NaruephonBoonmak/delta-uwb-presentation/assets/bom_r19/output/Poster_BOM_R19/transparent/04_BELT_MODULES_DETAIL_transparent.png

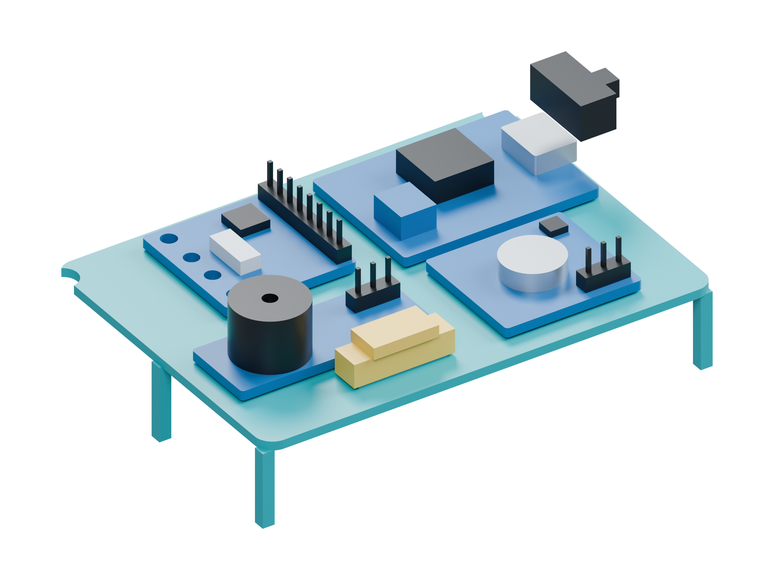
assets/bom_r19/output/Poster_BOM_R19/transparent/04_BELT_MODULES_DETAIL_transparent.png
