NaruephonBoonmak/delta-uwb-presentation/assets/cover/delta-agv-integrated-tag-cover.png

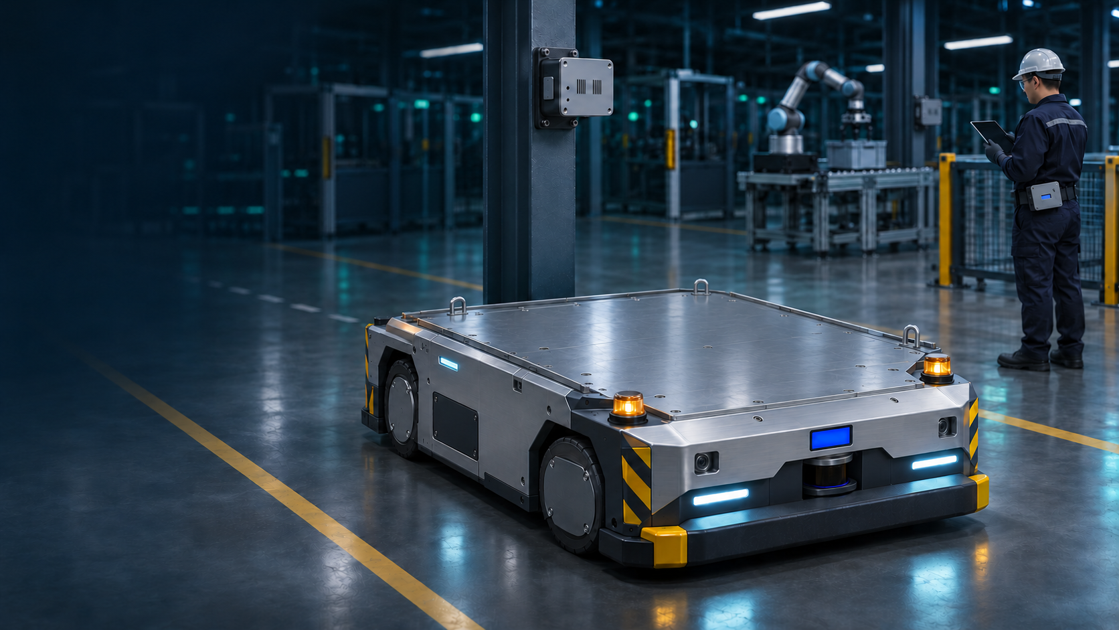
assets/cover/delta-agv-integrated-tag-cover.png
