NaruephonBoonmak/delta-uwb-presentation/assets/cover/delta-dark-factory-cover.png

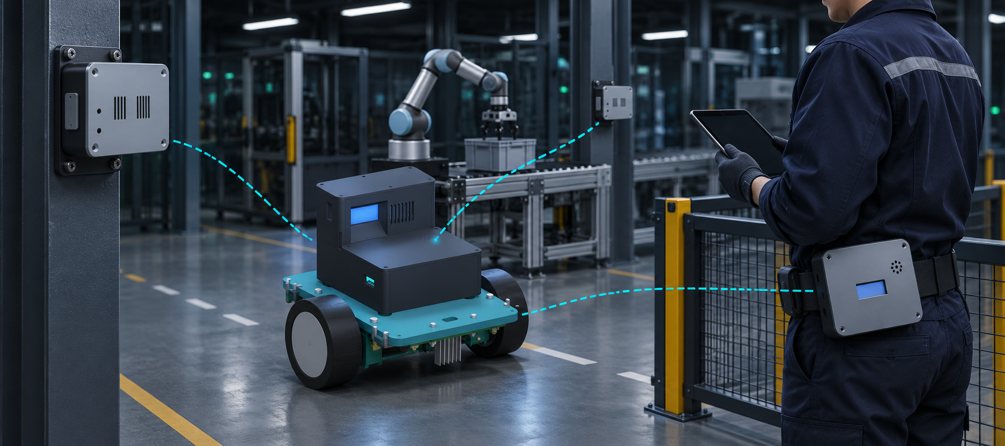
assets/cover/delta-dark-factory-cover.png
