NaruephonBoonmak/delta-uwb-presentation/assets/cover/delta-industrial-agv-cover.png

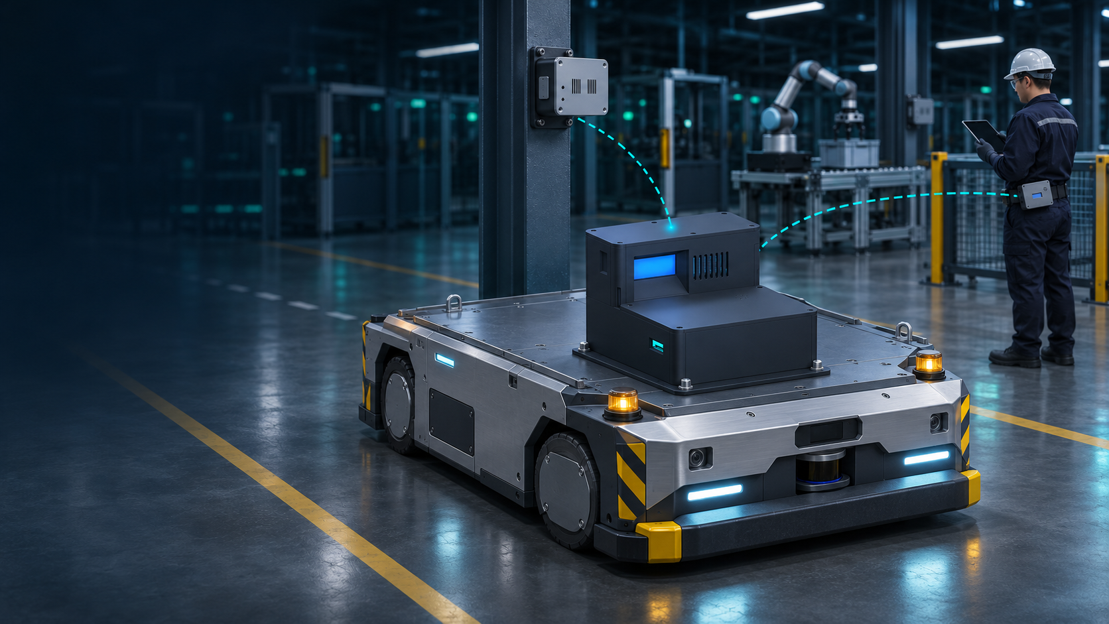
assets/cover/delta-industrial-agv-cover.png
