NaruephonBoonmak/delta-uwb-presentation/assets/cover/dtia-kmitl.webp

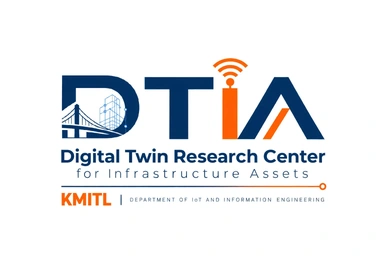
assets/cover/dtia-kmitl.webp
