NaruephonBoonmak/delta-uwb-presentation/assets/cover/kmitl-emblem.png

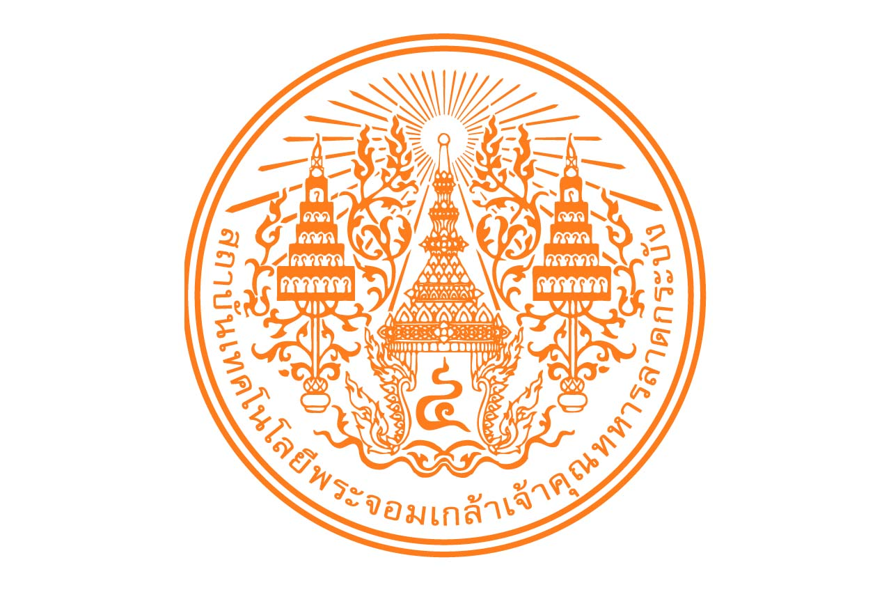
assets/cover/kmitl-emblem.png
