NaruephonBoonmak/delta-uwb-presentation/assets/cover/mecheci404-wordmark.png

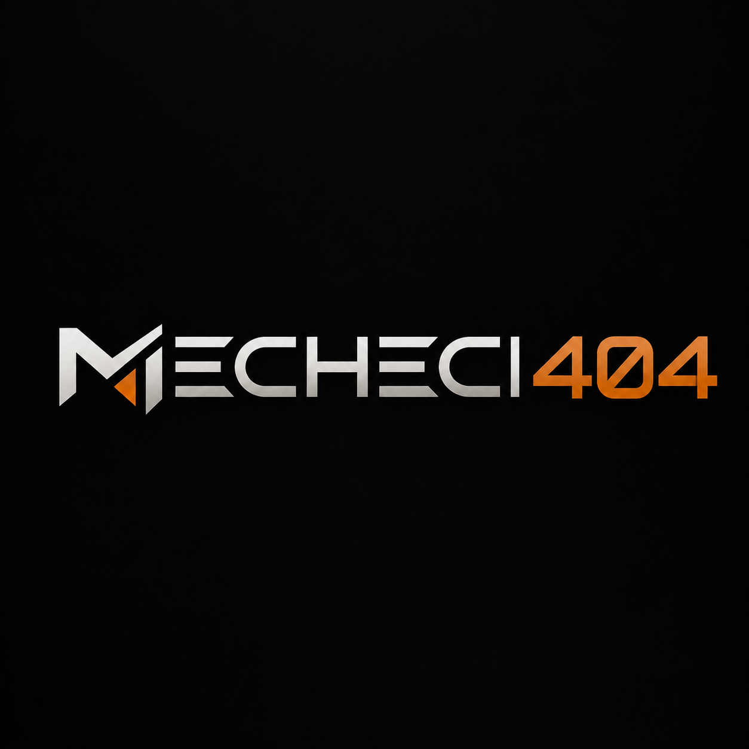
assets/cover/mecheci404-wordmark.png
