NaruephonBoonmak/delta-uwb-presentation/assets/package/04_Conveyor_450mm/Images/Conveyor_450_Rails_Aligned.png

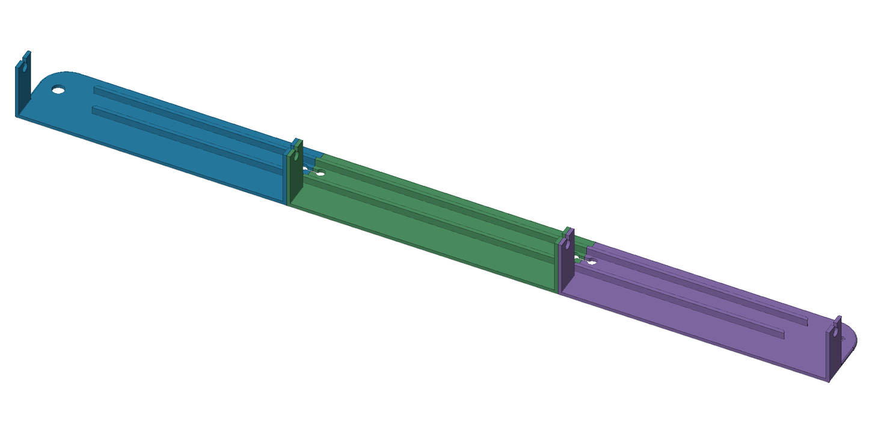
assets/package/04_Conveyor_450mm/Images/Conveyor_450_Rails_Aligned.png
