NaruephonBoonmak/delta-uwb-presentation/assets/package/04_Conveyor_450mm/Images/Conveyor_Source_CAD.png

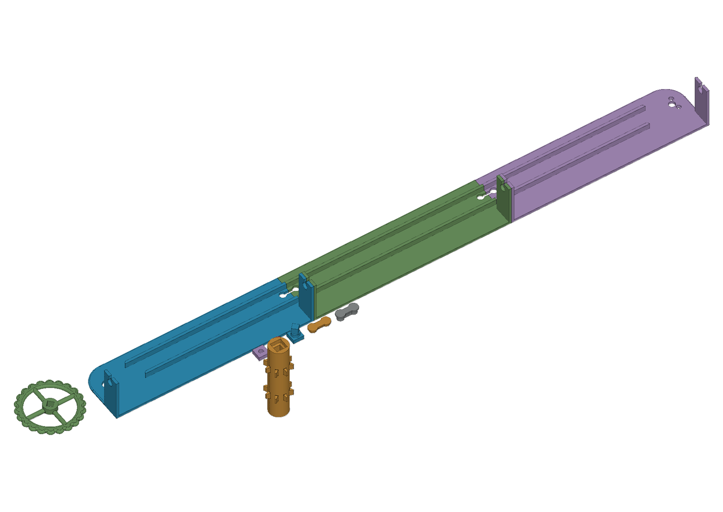
assets/package/04_Conveyor_450mm/Images/Conveyor_Source_CAD.png
