NaruephonBoonmak/delta-uwb-presentation/assets/package/04_Conveyor_450mm/Images/KW11_Bolted_Mount_Preview.png

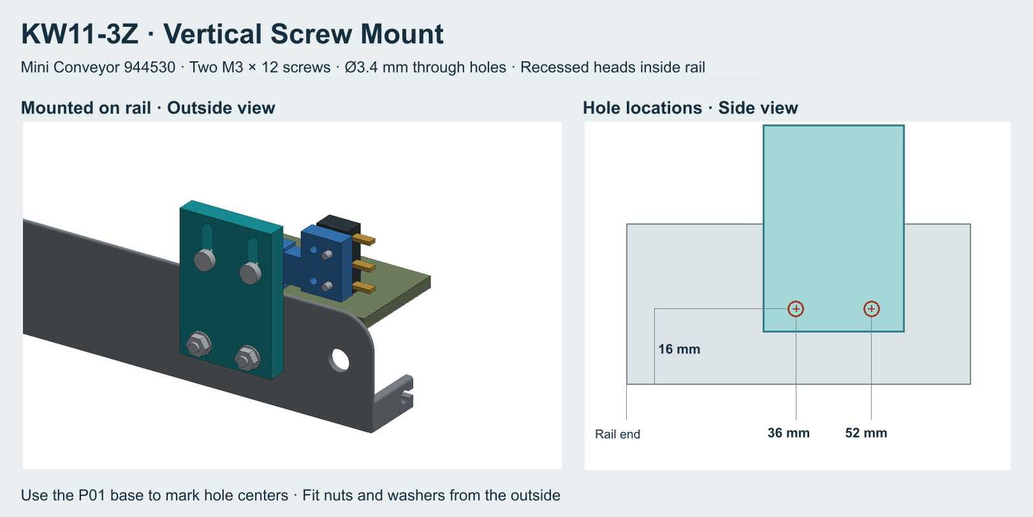
assets/package/04_Conveyor_450mm/Images/KW11_Bolted_Mount_Preview.png
