NaruephonBoonmak/delta-uwb-presentation/assets/package/05_AGV_Display_Stand_S01/Images/AGV_On_Stand_Baseline.png

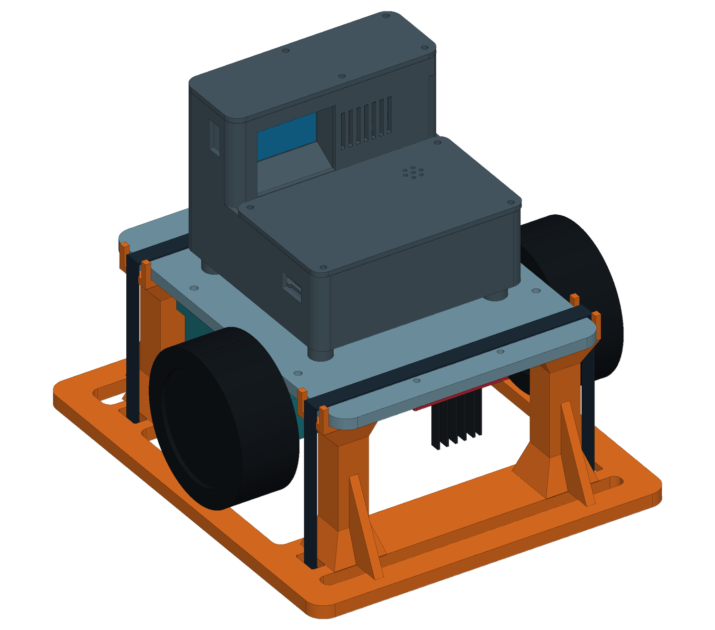
assets/package/05_AGV_Display_Stand_S01/Images/AGV_On_Stand_Baseline.png
