NaruephonBoonmak/delta-uwb-presentation/assets/package/05_AGV_Display_Stand_S01/Images/AGV_R20_Dual_TT_On_S01.png

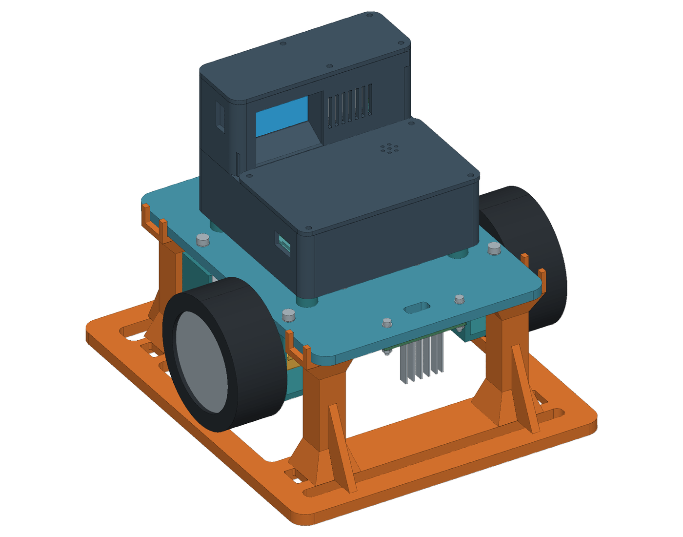
assets/package/05_AGV_Display_Stand_S01/Images/AGV_R20_Dual_TT_On_S01.png
