NaruephonBoonmak/delta-uwb-presentation/assets/package/05_AGV_Display_Stand_S01/Images/Stand_Clearance_Baseline.png

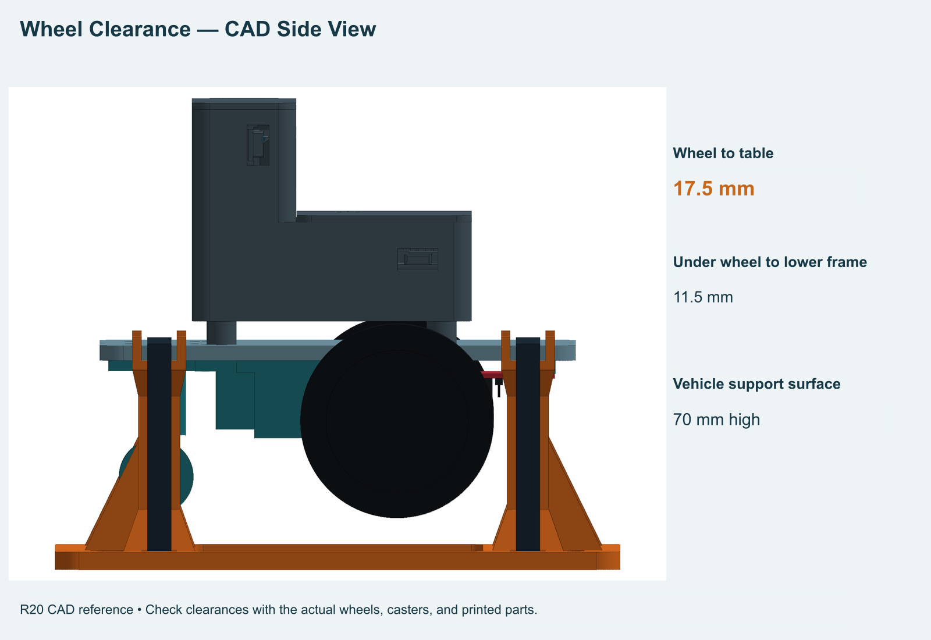
assets/package/05_AGV_Display_Stand_S01/Images/Stand_Clearance_Baseline.png
