NaruephonBoonmak/delta-uwb-presentation/assets/package/05_AGV_Display_Stand_S01/Images/Stand_Only.png

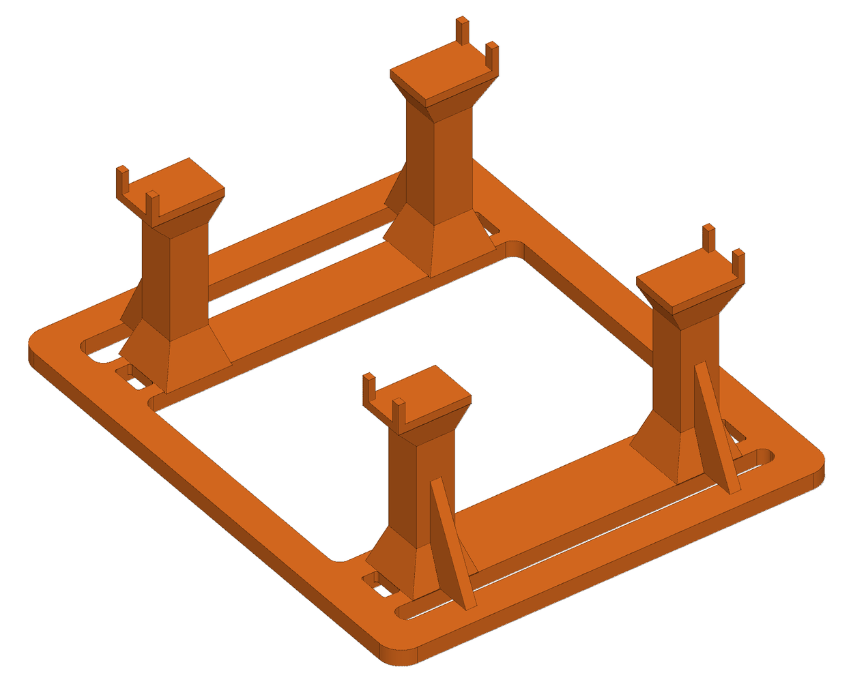
assets/package/05_AGV_Display_Stand_S01/Images/Stand_Only.png
