NaruephonBoonmak/delta-uwb-presentation/assets/package/08_Booth_Layout/Images/Booth_1800x600_Conveyor_450mm.png

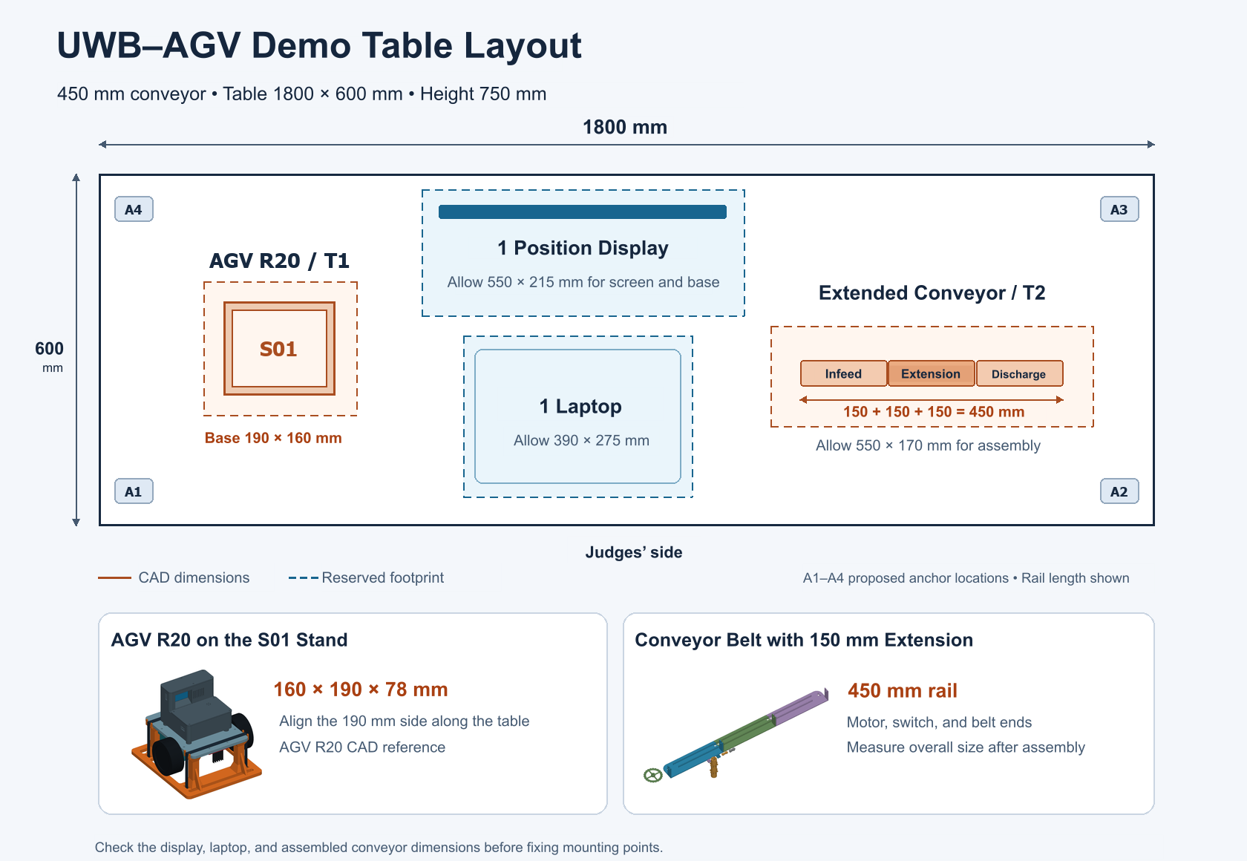
assets/package/08_Booth_Layout/Images/Booth_1800x600_Conveyor_450mm.png
