NaruephonBoonmak/delta-uwb-presentation/assets/prototype/Reviews/clip_review_20261028/dashboard_contact_sheet.png

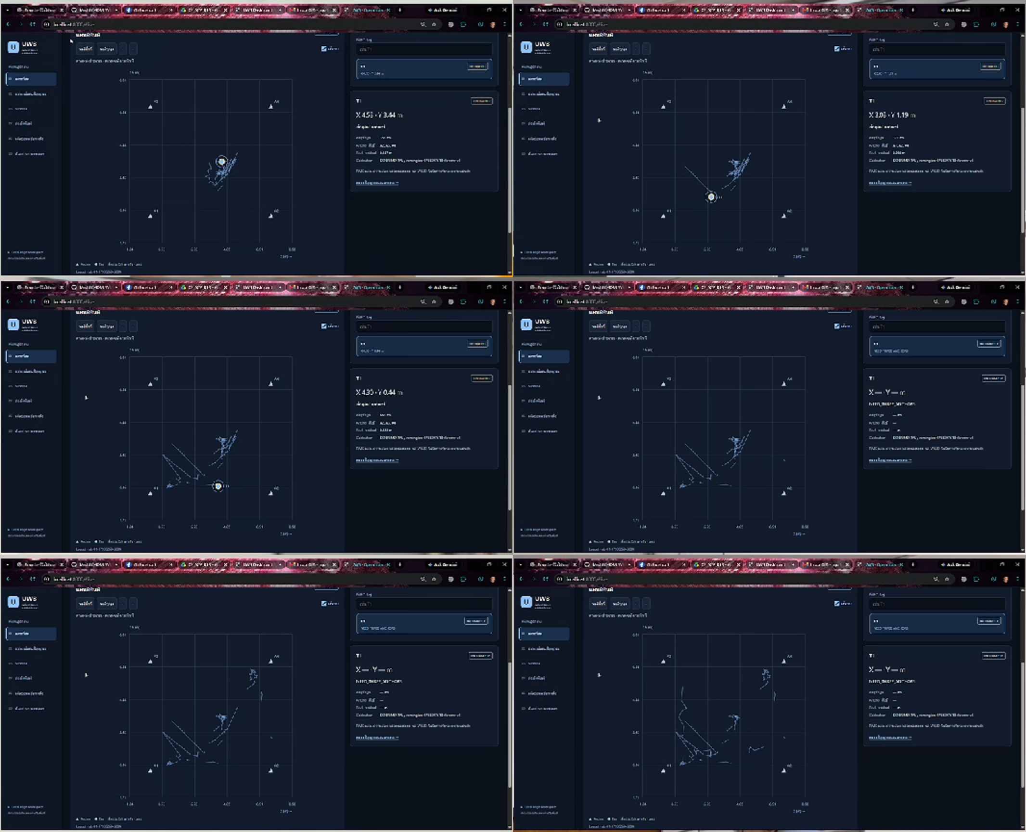
assets/prototype/Reviews/clip_review_20261028/dashboard_contact_sheet.png
