NaruephonBoonmak/delta-uwb-presentation/assets/qa/covers/schematics-l298n.webp

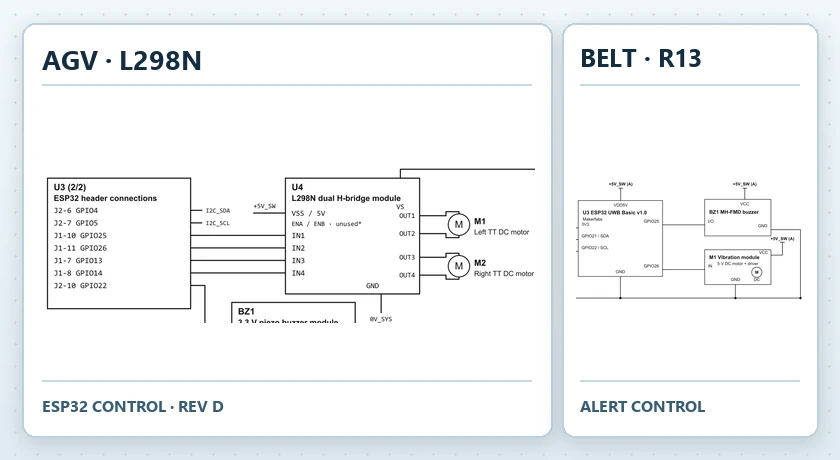
assets/qa/covers/schematics-l298n.webp
