NaruephonBoonmak/delta-uwb-presentation/assets/qa/covers/schematics.webp

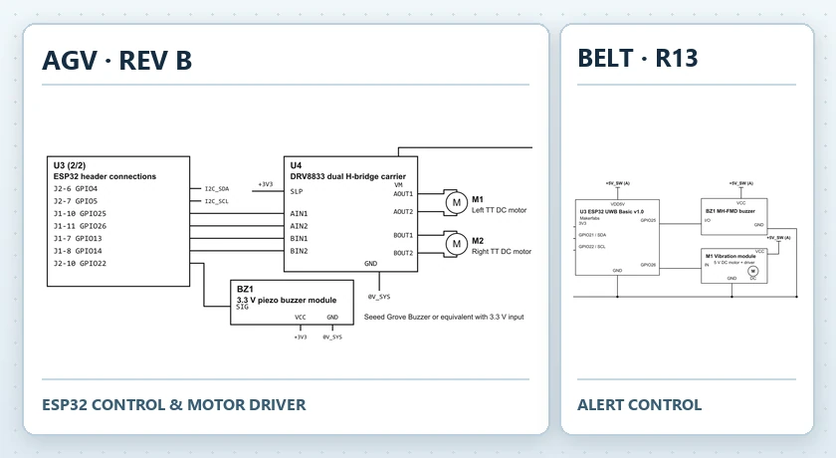
assets/qa/covers/schematics.webp
