NaruephonBoonmak/delta-uwb-presentation/assets/system/Presentation/Booth_1800x600_Layout_20261111.png

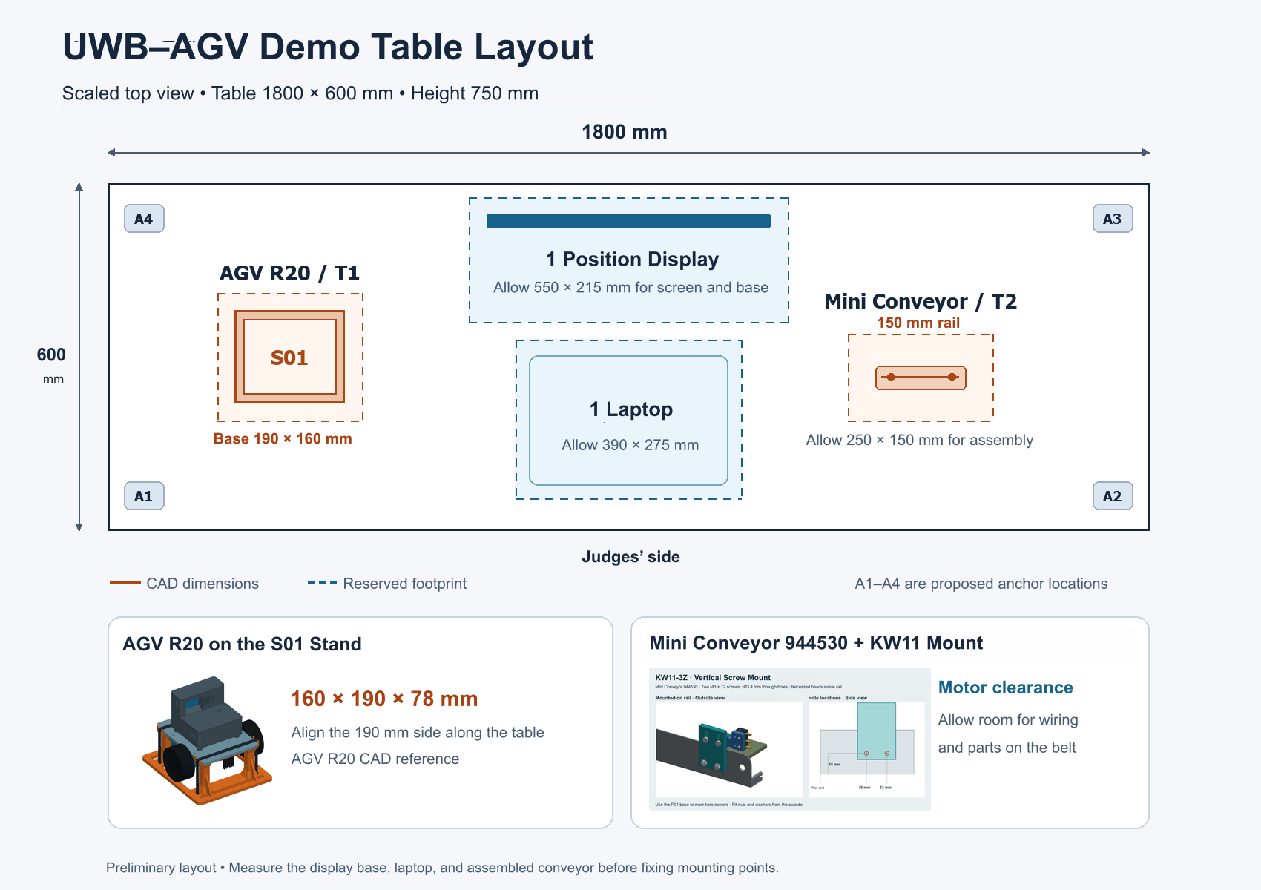
assets/system/Presentation/Booth_1800x600_Layout_20261111.png
