NaruephonBoonmak/delta-uwb-presentation/assets/system/Presentation/system-diagram/Delta_Cup_2026_System_Diagram.png

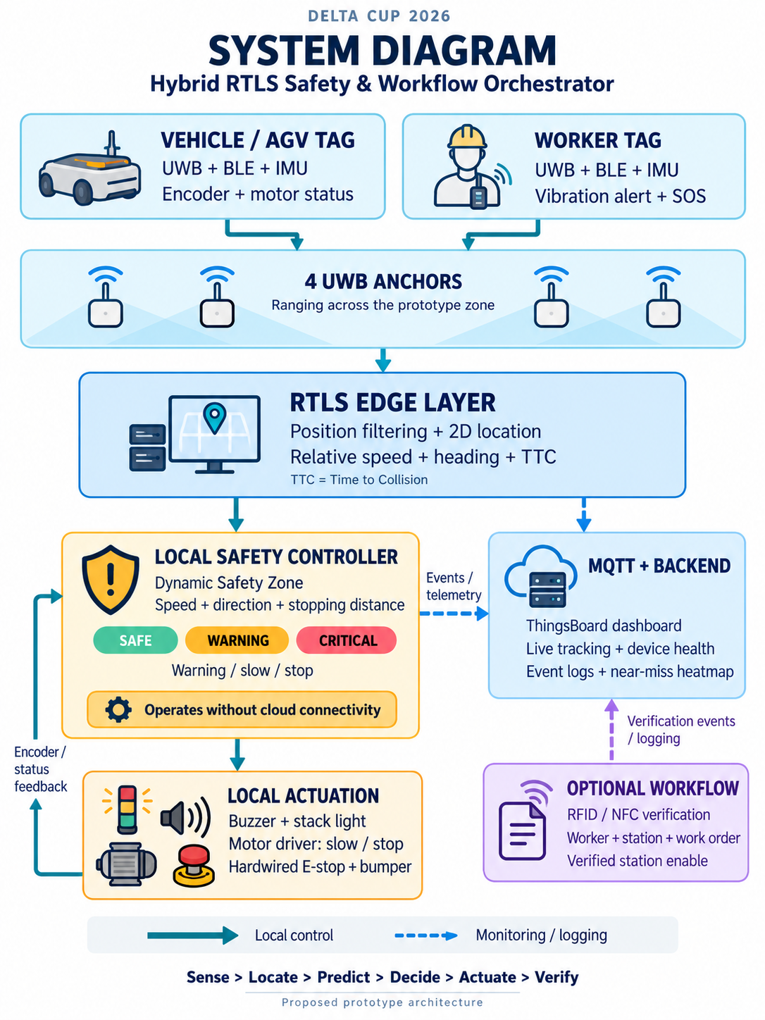
assets/system/Presentation/system-diagram/Delta_Cup_2026_System_Diagram.png
