NaruephonBoonmak/delta-uwb-presentation/assets/system/Presentation/system-diagram/Delta_Cup_2026_System_Diagram_No_MQTT.png

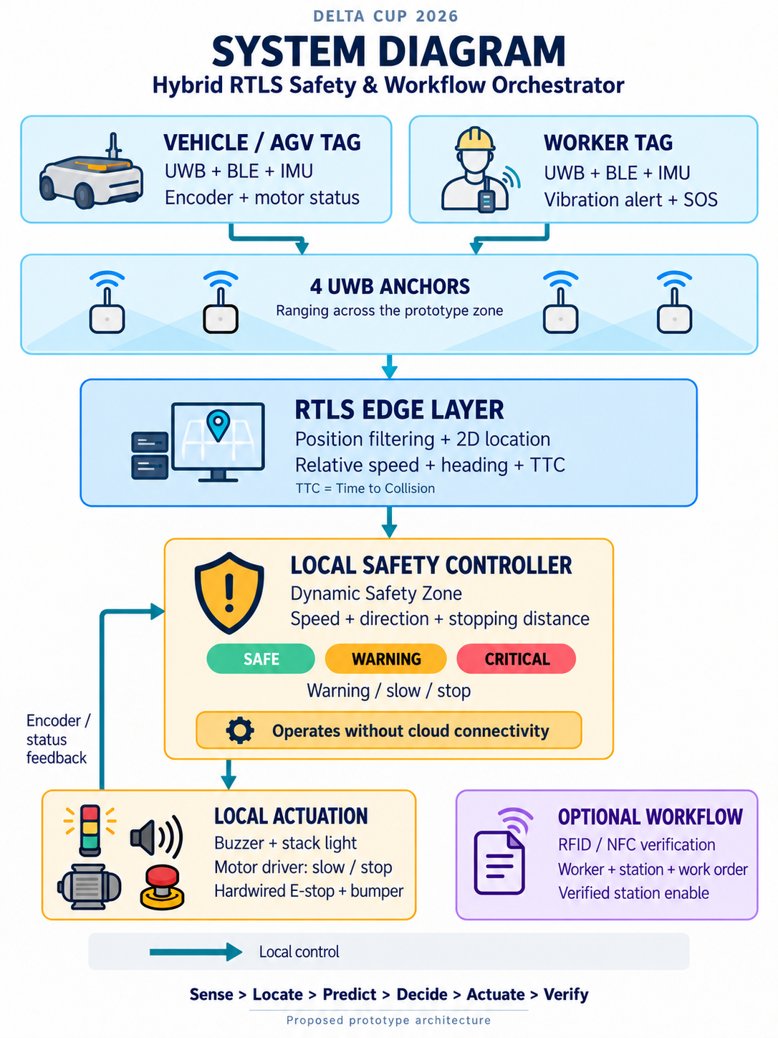
assets/system/Presentation/system-diagram/Delta_Cup_2026_System_Diagram_No_MQTT.png
