NaruephonBoonmak/delta-uwb-presentation/assets/package/03_Anchor_R05/Images/Anchor_R05_BOM_v2_transparent.png

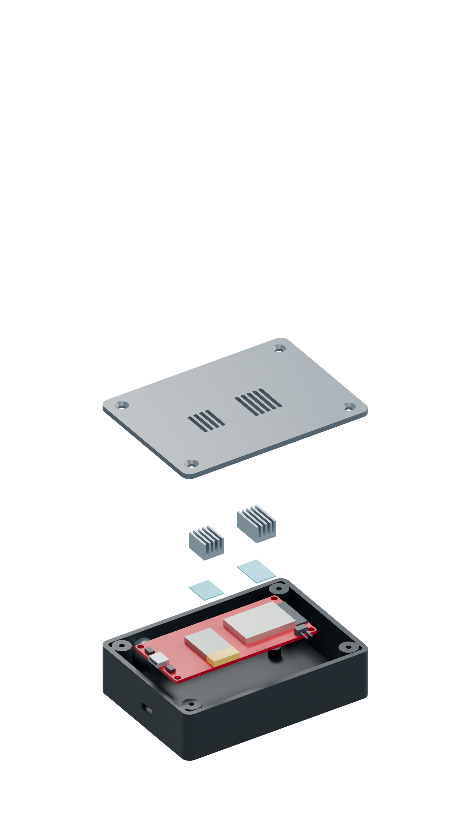
assets/package/03_Anchor_R05/Images/Anchor_R05_BOM_v2_transparent.png
