NaruephonBoonmak/delta-uwb-presentation/assets/package/01_AGV_R20/Print/Chassis/N01_Chassis_120x160_QTY1.stl

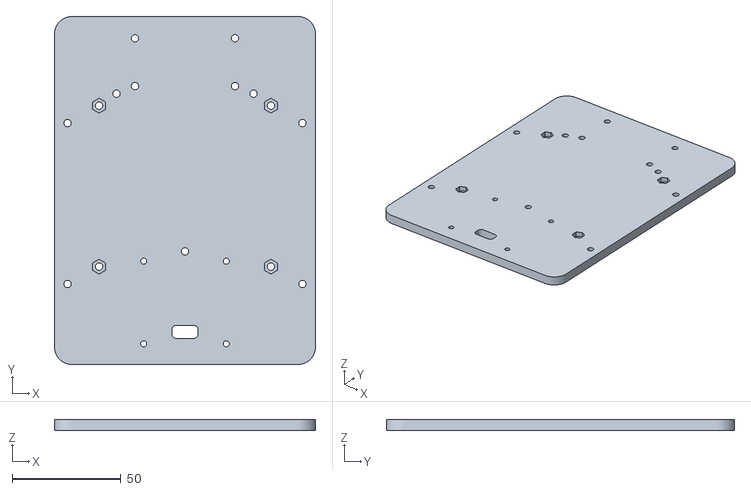
[picture p26: CAD file, 2026-11-12]
assets/package/01_AGV_R20/Print/Chassis/N01_Chassis_120x160_QTY1.stl
120.0 x 160.0 x 5.00
