NaruephonBoonmak/delta-uwb-presentation/assets/package/01_AGV_R20/Print/Enclosure_Split/STL/P01A_Lower_Base_Rear_Posts_Braced__PRINT.stl

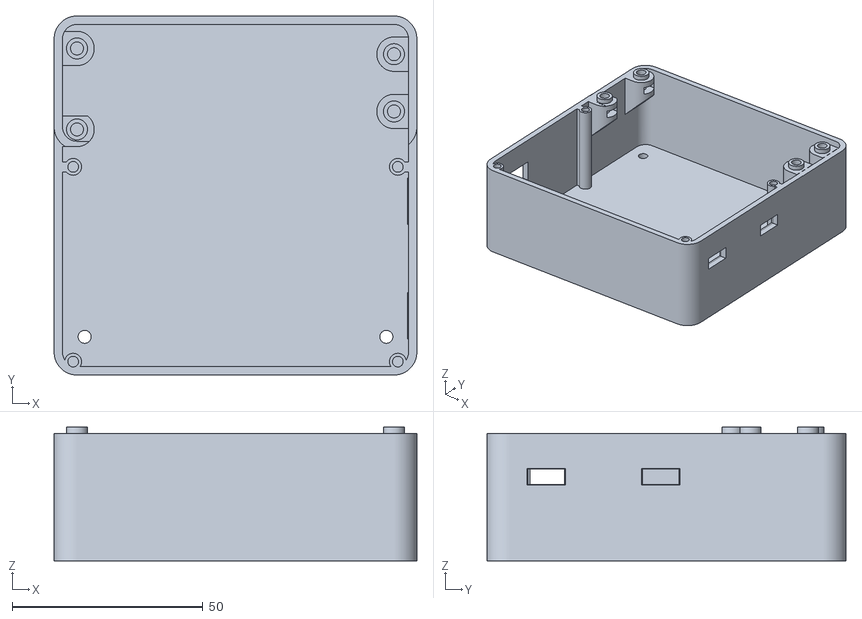
[picture p27: CAD file, 2026-11-12]
assets/package/01_AGV_R20/Print/Enclosure_Split/STL/P01A_Lower_Base_Rear_Posts_Braced__PRINT.stl
95.0 x 94.0 x 35.0
