NaruephonBoonmak/delta-uwb-presentation/assets/package/02_Belt_R18_A/Print/STL/P02_Front_Cover__PRINT.stl

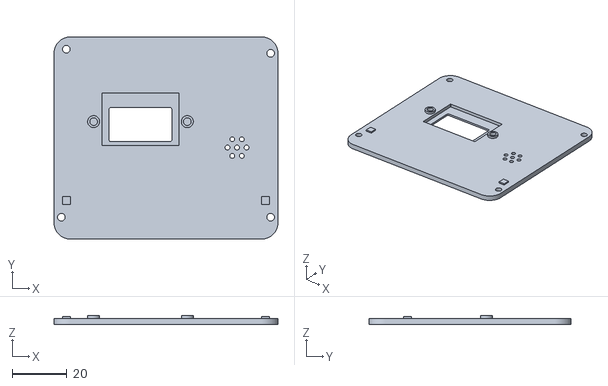
[picture p28: CAD file, 2026-11-12]
assets/package/02_Belt_R18_A/Print/STL/P02_Front_Cover__PRINT.stl
82.0 x 74.0 x 3.20
