NaruephonBoonmak/delta-uwb-presentation/assets/package/03_Anchor_R05/Print/P01_Base.stl

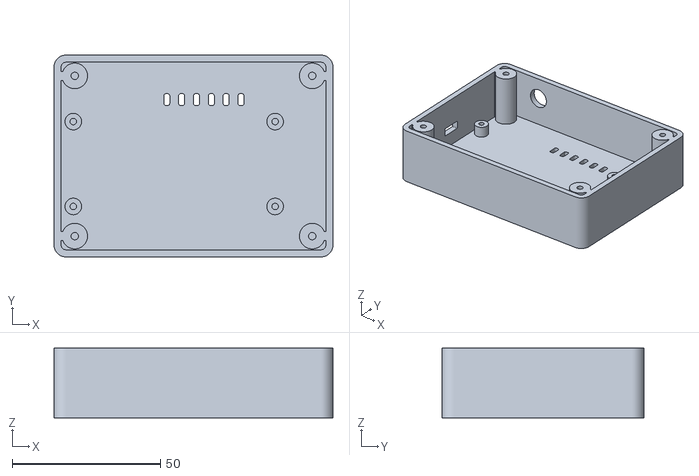
[picture p29: CAD file, 2026-11-12]
assets/package/03_Anchor_R05/Print/P01_Base.stl
94.0 x 68.0 x 23.5
