NaruephonBoonmak/delta-uwb-presentation/assets/package/04_Conveyor_450mm/Print/Mini_944530/P02_KW11_Vertical_Carrier_QTY2.stl

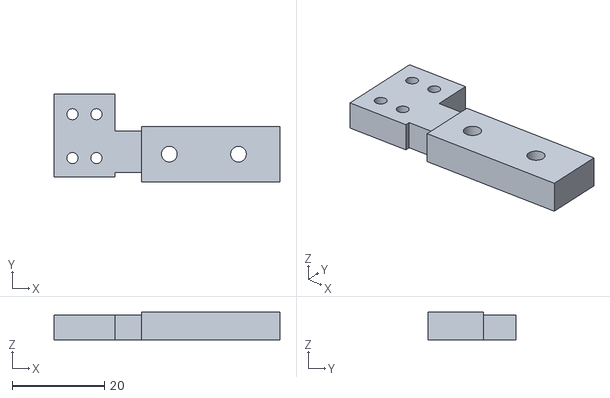
[picture p30: CAD file, 2026-11-12]
assets/package/04_Conveyor_450mm/Print/Mini_944530/P02_KW11_Vertical_Carrier_QTY2.stl
49.0 x 19.0 x 6.00
