NaruephonBoonmak/delta-uwb-presentation/assets/package/05_AGV_Display_Stand_S01/Print/S01_R20_Free_Wheel_Display_Stand__PRINT.stl

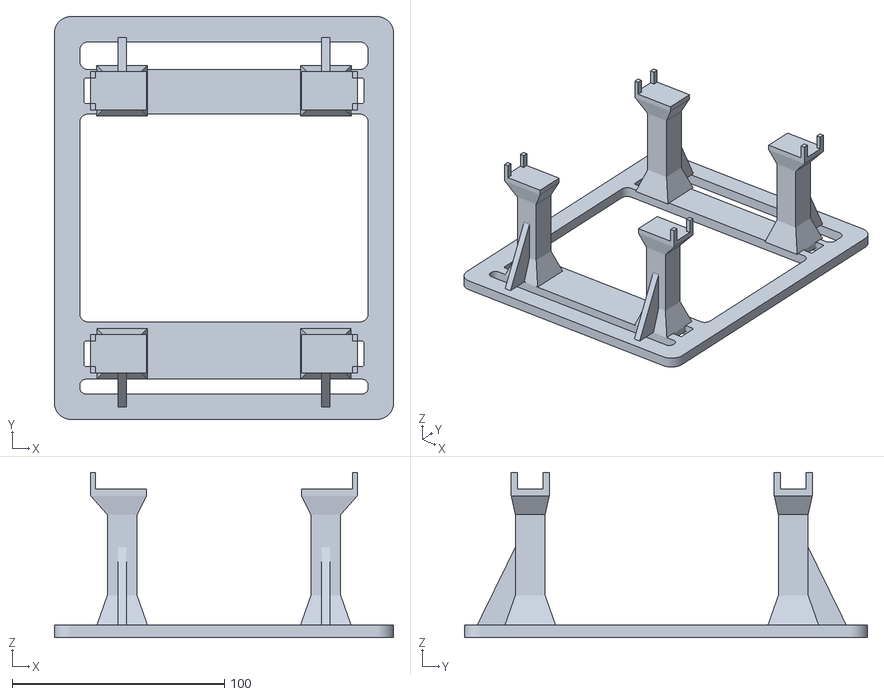
[picture p31: CAD file, 2026-11-12]
assets/package/05_AGV_Display_Stand_S01/Print/S01_R20_Free_Wheel_Display_Stand__PRINT.stl
160.0 x 190.0 x 78.0
