NaruephonBoonmak/delta-uwb-presentation/assets/package/06_Relay_Control_R01/Print/Lid.stl

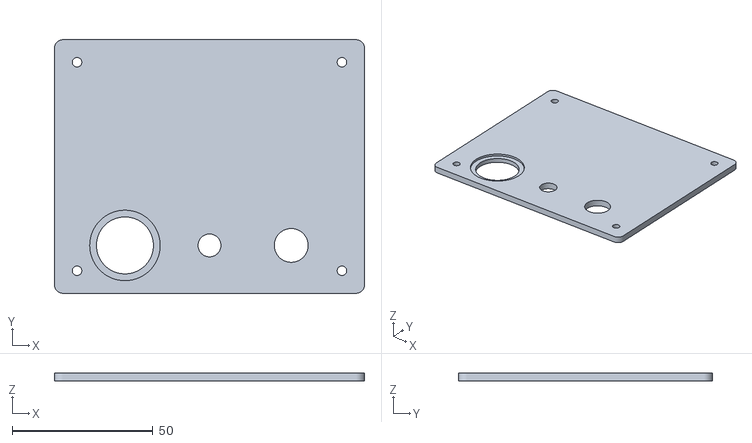
[picture p32: CAD file, 2026-11-12]
assets/package/06_Relay_Control_R01/Print/Lid.stl
110.0 x 90.0 x 3.00
