NaruephonBoonmak/delta-uwb-presentation/assets/package/01_AGV_R20/Print/Enclosure_Split/STL/P01B_Upper_Tower__PRINT.stl

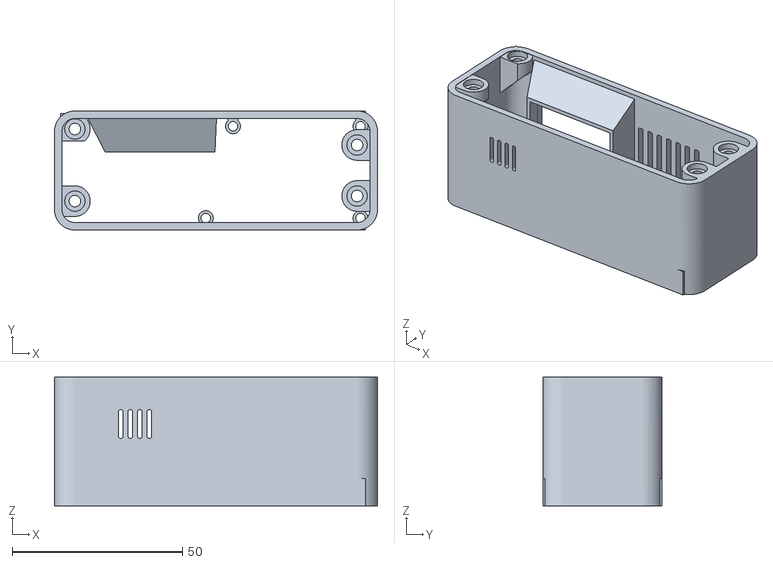
[picture p33: CAD file, 2026-11-12]
assets/package/01_AGV_R20/Print/Enclosure_Split/STL/P01B_Upper_Tower__PRINT.stl
95.0 x 35.0 x 37.9
