NaruephonBoonmak/delta-uwb-presentation/assets/package/02_Belt_R18_A/Print/STL/P06_Closed_Belt_Loop_Backplate__PRINT.stl

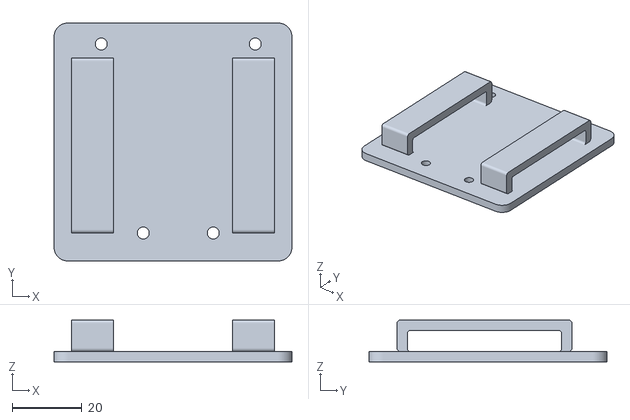
[picture p34: CAD file, 2026-11-12]
assets/package/02_Belt_R18_A/Print/STL/P06_Closed_Belt_Loop_Backplate__PRINT.stl
68.0 x 68.0 x 12.0
