NaruephonBoonmak/delta-uwb-presentation/assets/package/03_Anchor_R05/Print/P02_Lid.stl

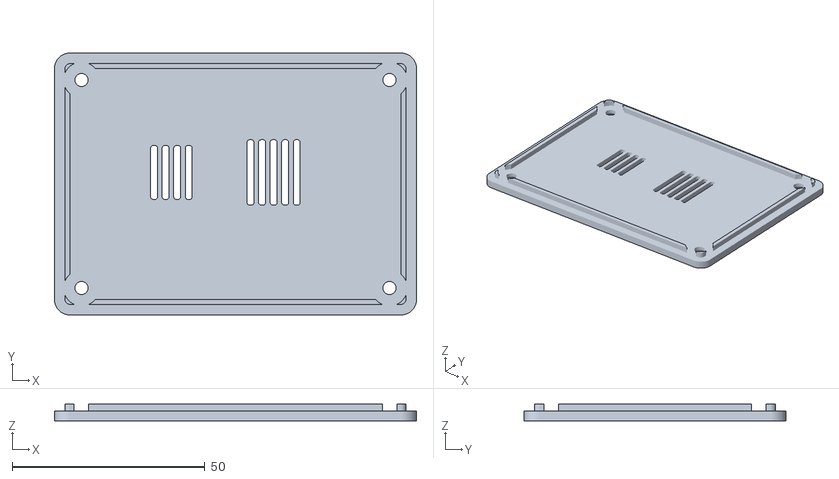
[picture p35: CAD file, 2026-11-12]
assets/package/03_Anchor_R05/Print/P02_Lid.stl
94.0 x 68.0 x 4.30
