NaruephonBoonmak/delta-uwb-presentation/assets/package/04_Conveyor_450mm/Print/Mini_944530/P01_Vertical_M3_Drilled_Base_QTY2.stl

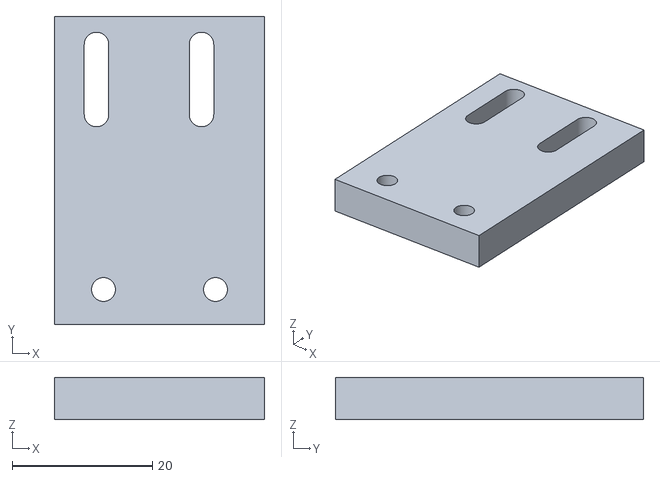
[picture p36: CAD file, 2026-11-12]
assets/package/04_Conveyor_450mm/Print/Mini_944530/P01_Vertical_M3_Drilled_Base_QTY2.stl
30.0 x 44.0 x 6.00
