NaruephonBoonmak/delta-uwb-presentation/assets/package/06_Relay_Control_R01/Print/Base.stl

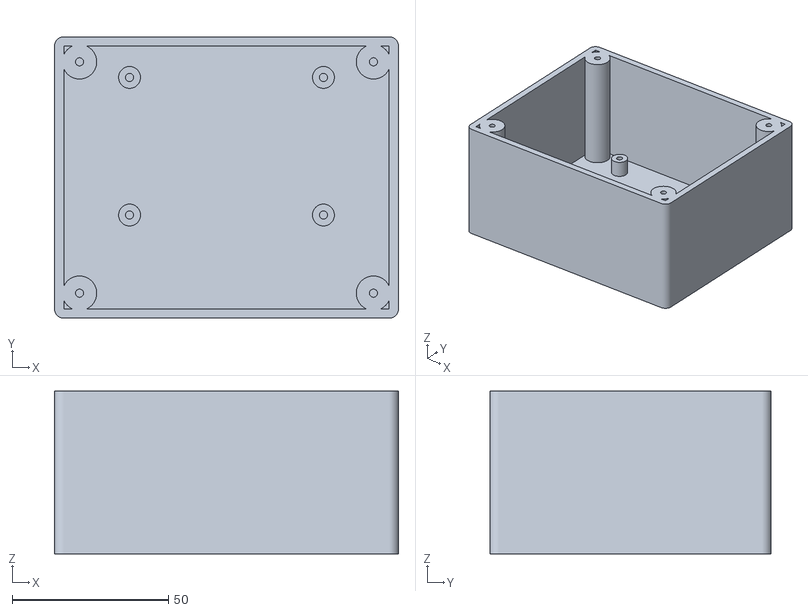
[picture p37: CAD file, 2026-11-12]
assets/package/06_Relay_Control_R01/Print/Base.stl
110.0 x 90.0 x 52.0
