NaruephonBoonmak/delta-uwb-presentation/assets/package/02_Belt_R18_A/Print/STL/P01_Housing_A_Captive_Nuts__PRINT.stl

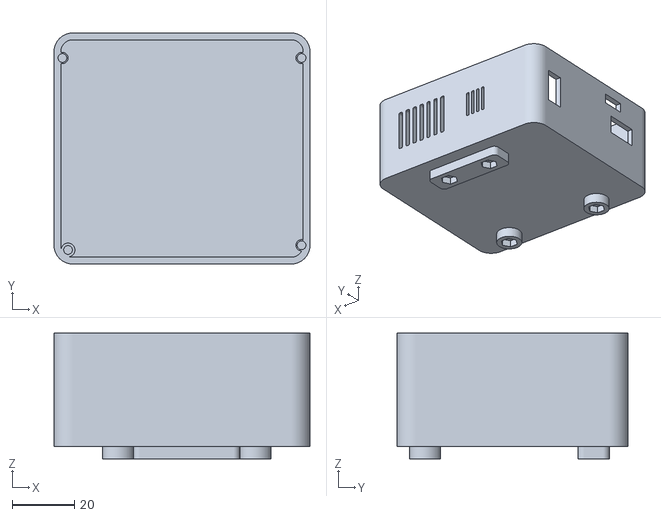
[picture p38: CAD file, 2026-11-12]
assets/package/02_Belt_R18_A/Print/STL/P01_Housing_A_Captive_Nuts__PRINT.stl
82.0 x 74.0 x 40.2
