NaruephonBoonmak/delta-uwb-presentation/assets/cad_assembled/output/Three_Models_Assembled_R20/transparent/01_BELT_Assembled_transparent.png

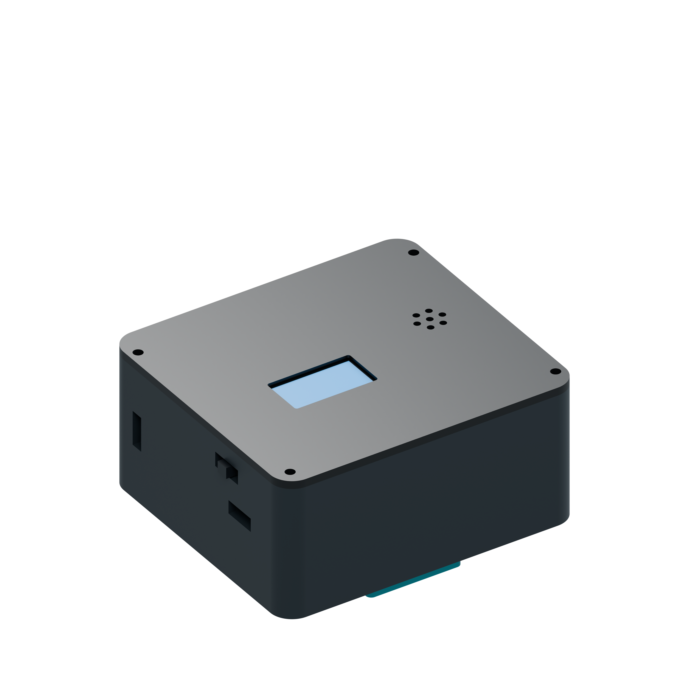
assets/cad_assembled/output/Three_Models_Assembled_R20/transparent/01_BELT_Assembled_transparent.png
