NaruephonBoonmak/delta-uwb-presentation/assets/package/06_Relay_Control_R01/Images/Relay_R01_Assembled.png

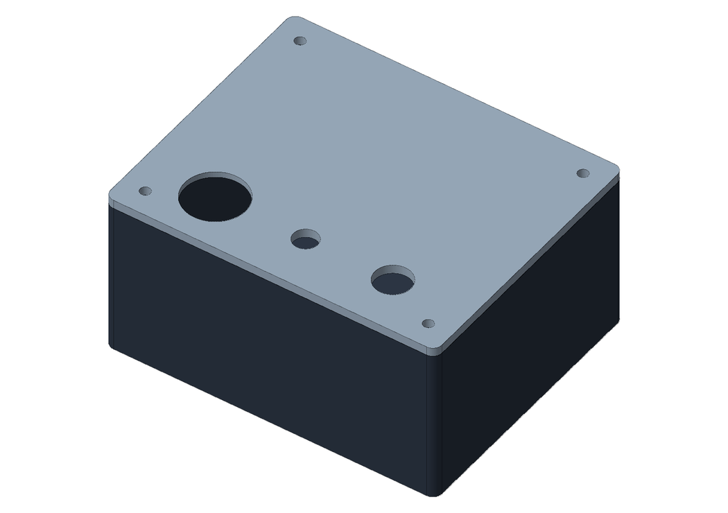
assets/package/06_Relay_Control_R01/Images/Relay_R01_Assembled.png
