NaruephonBoonmak/delta-uwb-presentation/assets/wiring/agv_belt_wiring_ina226_r09/output/AGV_Belt_INA226_R09/01_AGV_MEGA_Combined_R09.png

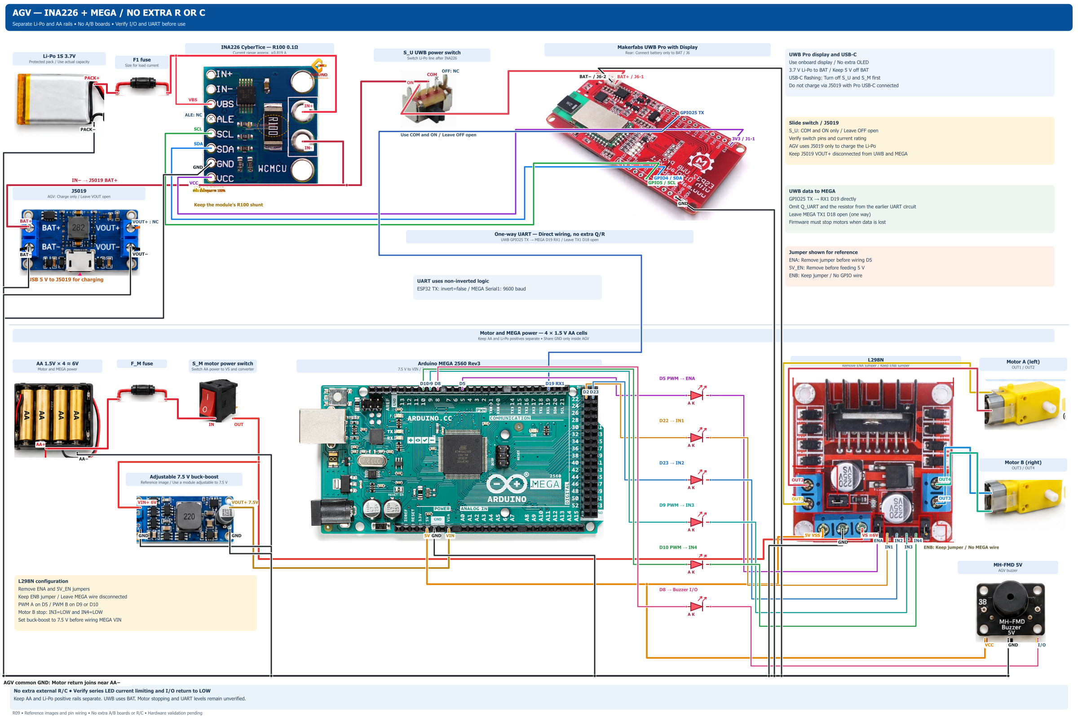
assets/wiring/agv_belt_wiring_ina226_r09/output/AGV_Belt_INA226_R09/01_AGV_MEGA_Combined_R09.png
