NaruephonBoonmak/delta-uwb-presentation/assets/wiring/agv_belt_wiring_ina226_r09/output/AGV_Belt_INA226_R09/source/assets/references_contact.png

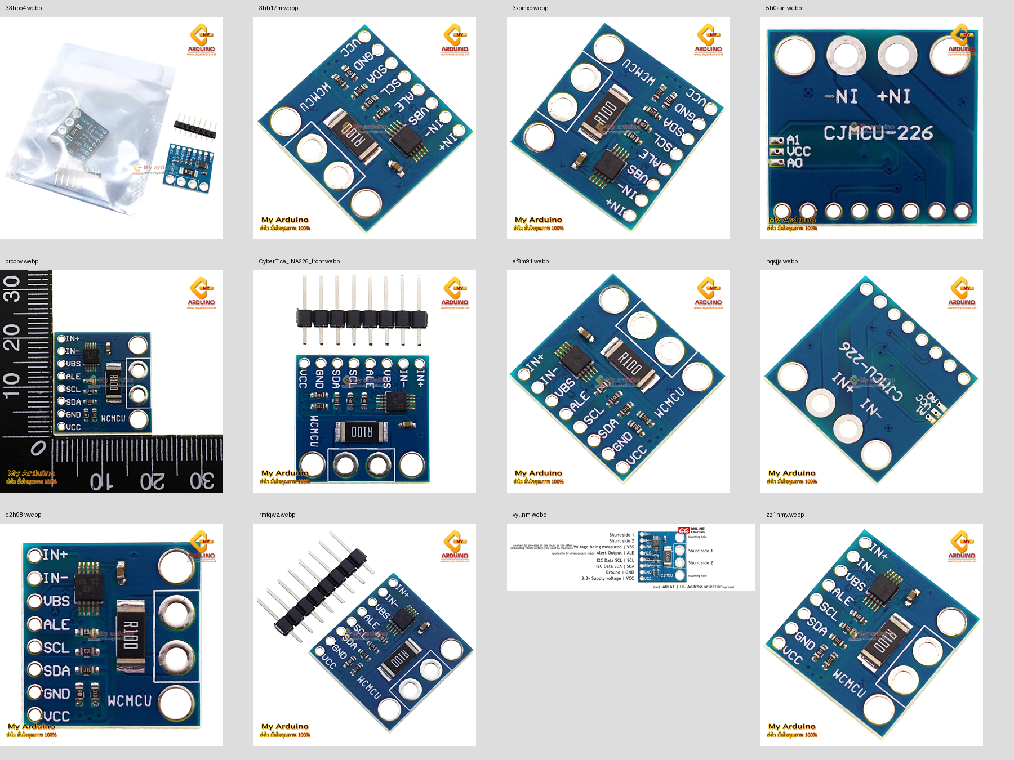
assets/wiring/agv_belt_wiring_ina226_r09/output/AGV_Belt_INA226_R09/source/assets/references_contact.png
