NaruephonBoonmak/delta-uwb-presentation/assets/wiring/agv_belt_wiring_physical_pins_r05_part01/output/AGV_Belt_Physical_Pins_R05/02_AGV_Motor_Real_Pins.png

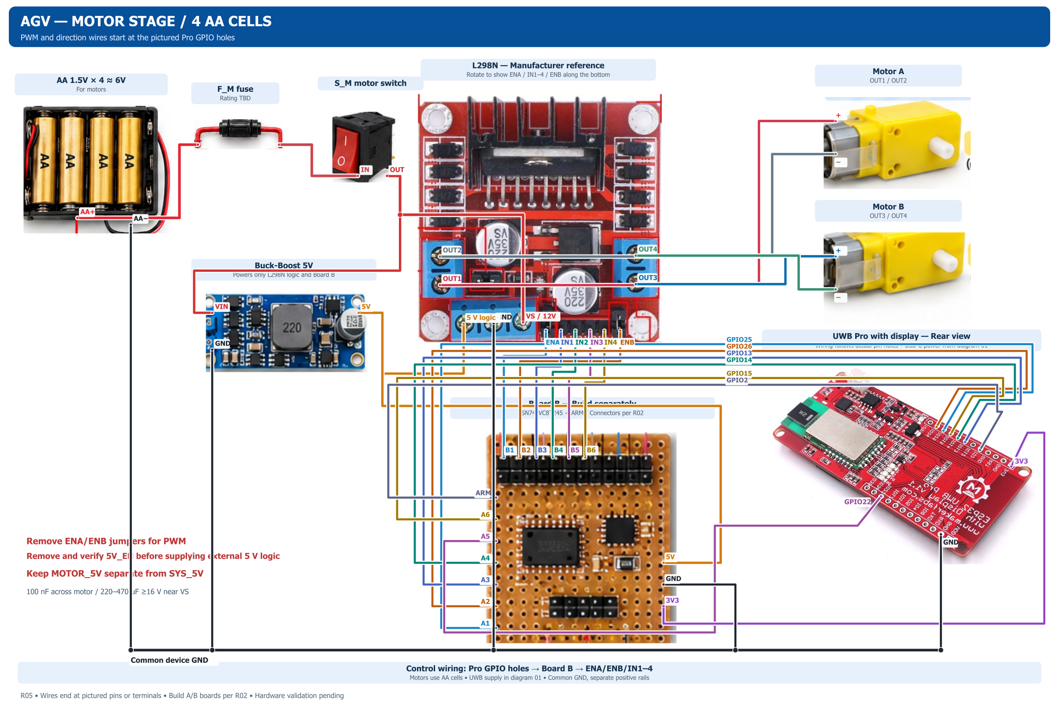
assets/wiring/agv_belt_wiring_physical_pins_r05_part01/output/AGV_Belt_Physical_Pins_R05/02_AGV_Motor_Real_Pins.png
