NaruephonBoonmak/delta-uwb-presentation/assets/qa/covers/cad.webp

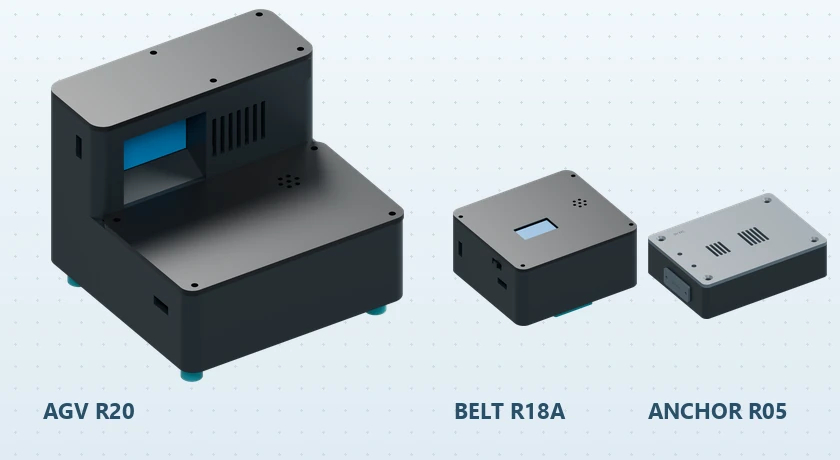
assets/qa/covers/cad.webp
