NaruephonBoonmak/delta-uwb-presentation/assets/qa/covers/calibration.webp

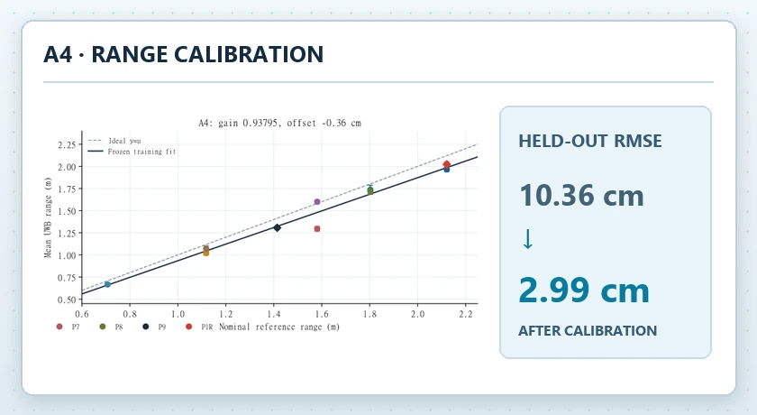
assets/qa/covers/calibration.webp
