NaruephonBoonmak/delta-uwb-presentation/assets/qa/covers/references.webp

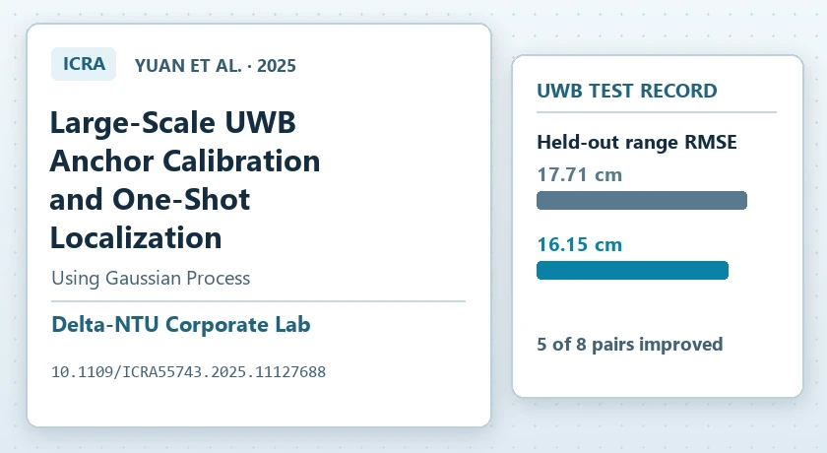
assets/qa/covers/references.webp
