NaruephonBoonmak/delta-uwb-presentation/(commit log)

2026-11-12 Publish DELTA UWB presentation
    [Base.stl, Lid.stl, N01_Chassis_120x160_QTY1.stl, P01A_Lower_Base_Rear_Posts_Braced__PRINT.stl, P01B_Upper_Tower__PRINT.stl, P01_Base.stl, P01_Housing_A_Captive_Nuts__PRINT.stl, P01_Vertical_M3_Drilled_Base_QTY2.stl]
2026-11-13 Update print statement from 'Hello' to 'Goodbye'Update the presentation cover title
2026-11-13 Translate the DELTA presentation and update slides 2–5
2026-11-13 Translate wiring diagrams
2026-11-13 Translate physical pin diagrams
2026-11-13 Translate conveyor mounting labels
2026-11-13 Refresh Delta Q&A and electrical schematics
2026-11-13 Ground Delta slides in UWB research and prototype evidence
2026-11-13 Show AGV L298N Rev D wiring and interactive booth CAD
2026-11-13 Match the CAD booth layout to the slide 6 scene
2026-11-13 Replace legacy calibration results with PDF assessment
    [data.js]
